adham404/Open8-VGA/enclosure/out/img/front.png

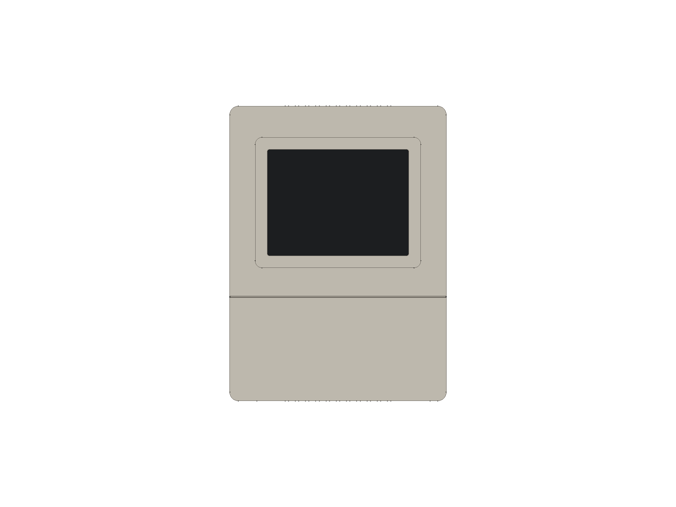
enclosure/out/img/front.png
