adham404/Open8-VGA/enclosure/out/img/rear_right.png

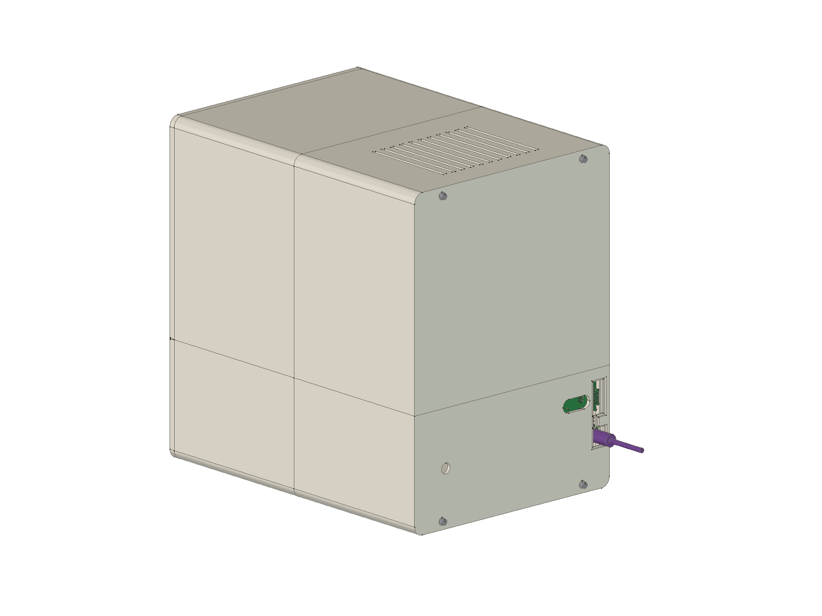
enclosure/out/img/rear_right.png
