adham404/Open8-VGA/hardware/fab/rev-a/open8-vga-top-revA.png

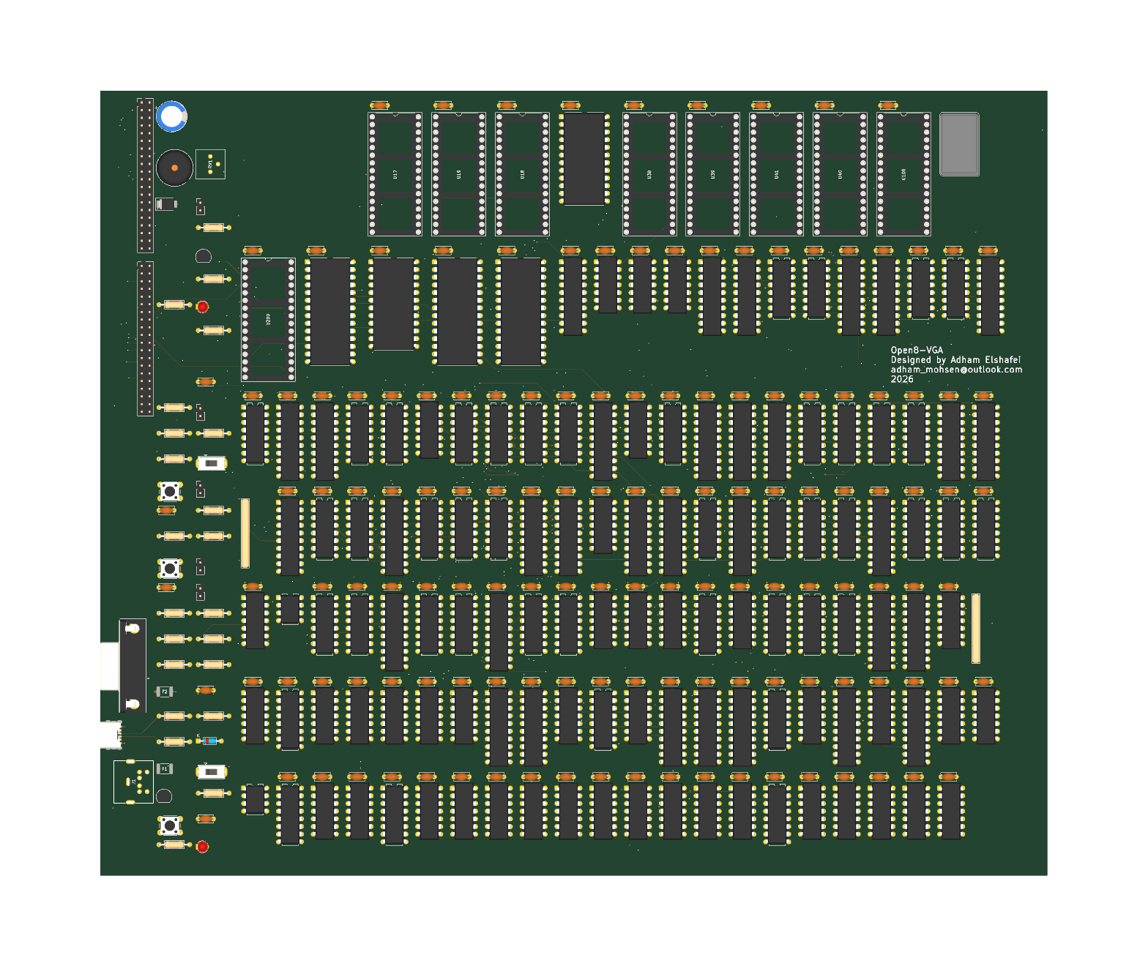
hardware/fab/rev-a/open8-vga-top-revA.png
