adham404/Open8-VGA/enclosure/out/shell_lower_rear.stl

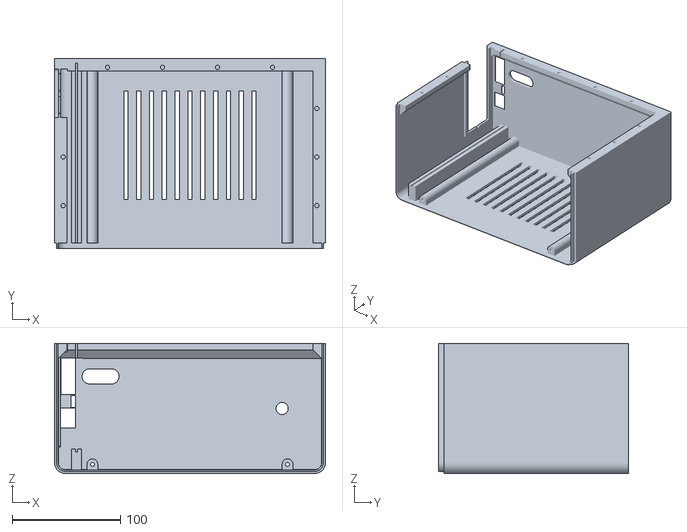
[picture p19: CAD file, 2026-10-21]
enclosure/out/shell_lower_rear.stl
250.0 x 175.0 x 120.0
