adham404/Open8-VGA/enclosure/out/shell_lower_front.stl

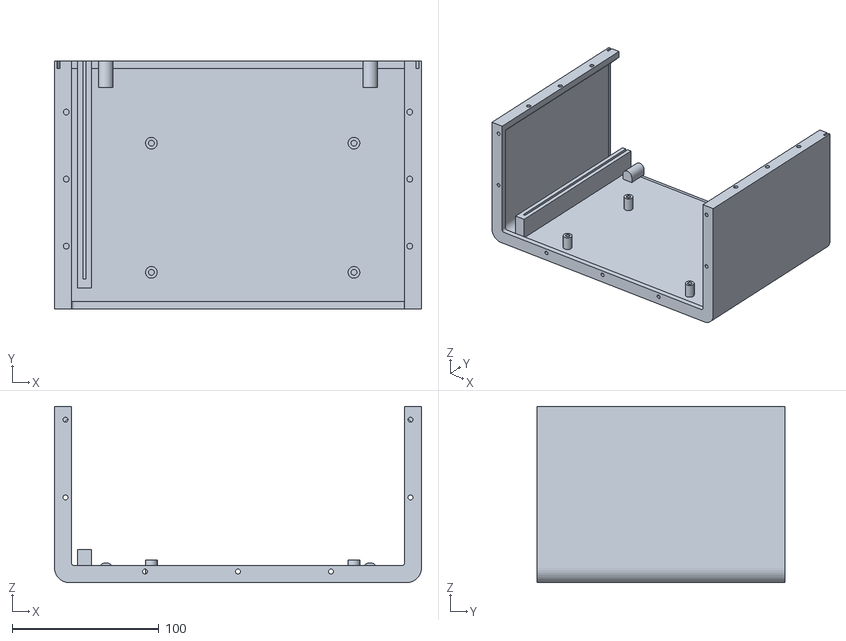
[picture p20: CAD file, 2026-10-21]
enclosure/out/shell_lower_front.stl
250.0 x 169.0 x 120.0
