adham404/Open8-VGA/enclosure/out/open8-vga-enclosure.step

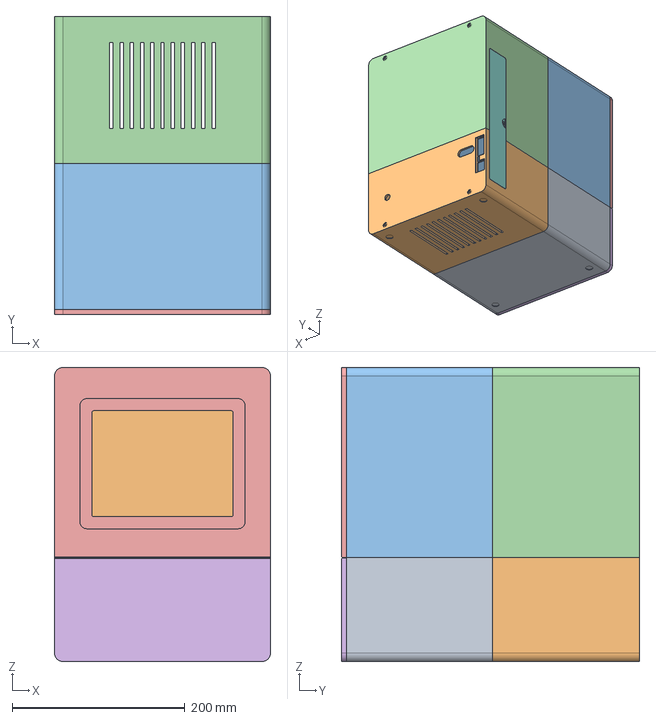
[picture p21: CAD file, 2026-10-21]
enclosure/out/open8-vga-enclosure.step
250.0 x 345.0 x 340.0 mm
