adham404/Open8-VGA/enclosure/out/shell_upper_rear.stl

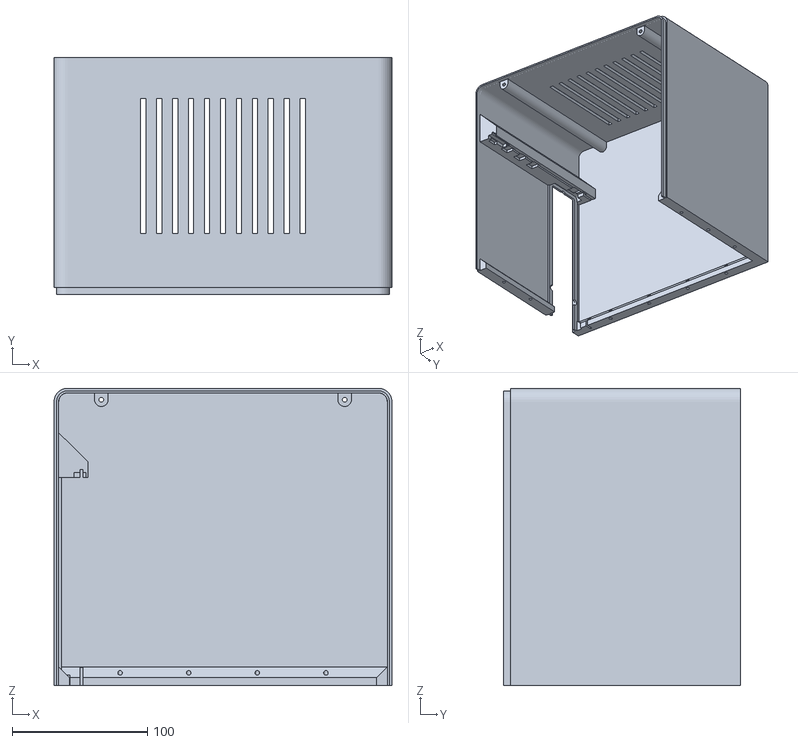
[picture p22: CAD file, 2026-10-21]
enclosure/out/shell_upper_rear.stl
250.0 x 175.0 x 220.0
