adham404/Open8-VGA/enclosure/out/bezel_upper.stl

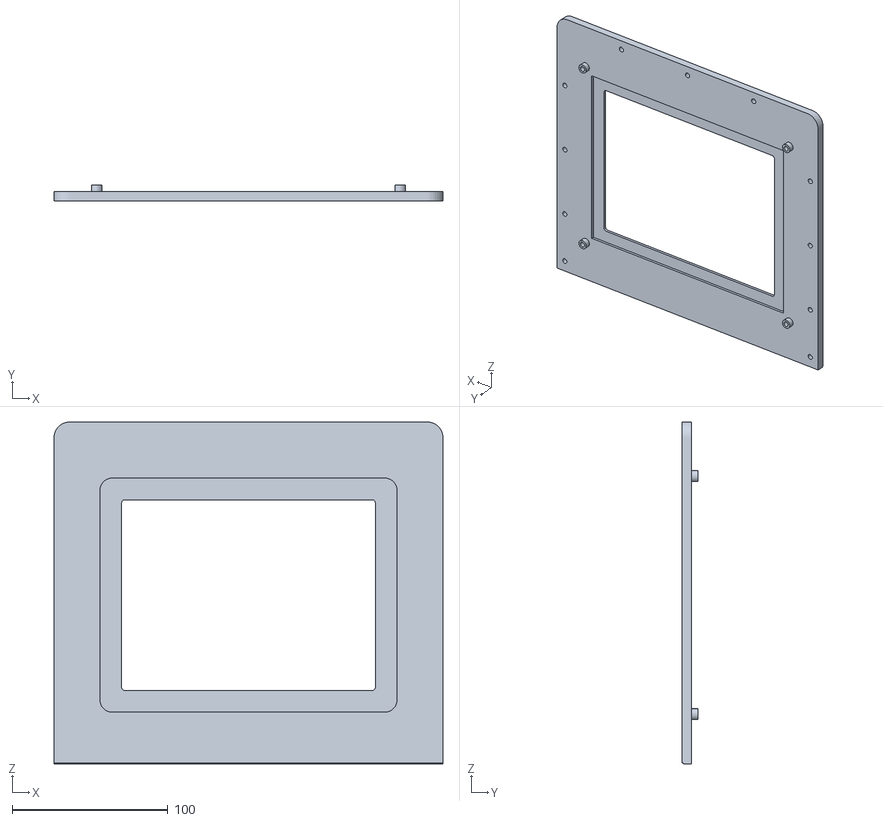
[picture p24: CAD file, 2026-10-20]
enclosure/out/bezel_upper.stl
250.0 x 10.0 x 219.8
