adham404/Open8-VGA/enclosure/out/controls_door.stl

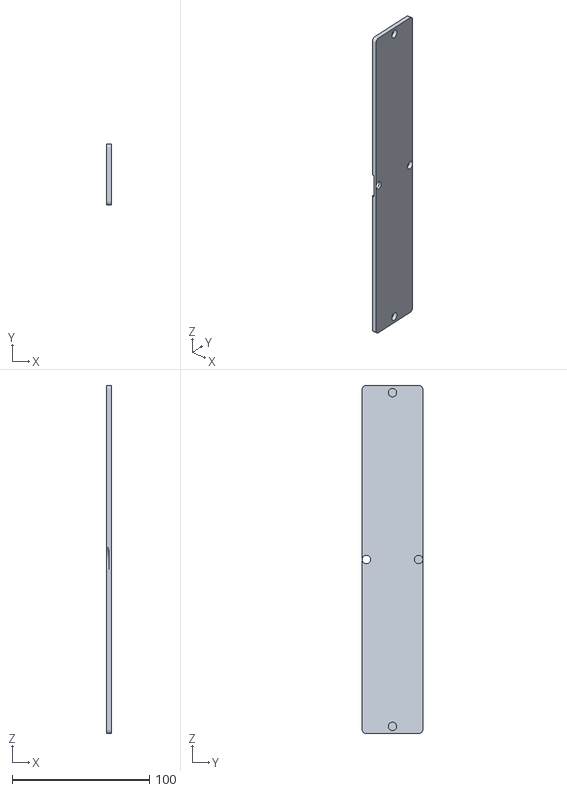
[picture p25: CAD file, 2026-10-20]
enclosure/out/controls_door.stl
3.50 x 44.4 x 253.5
