adham404/Open8-VGA/enclosure/out/driver_tray.stl

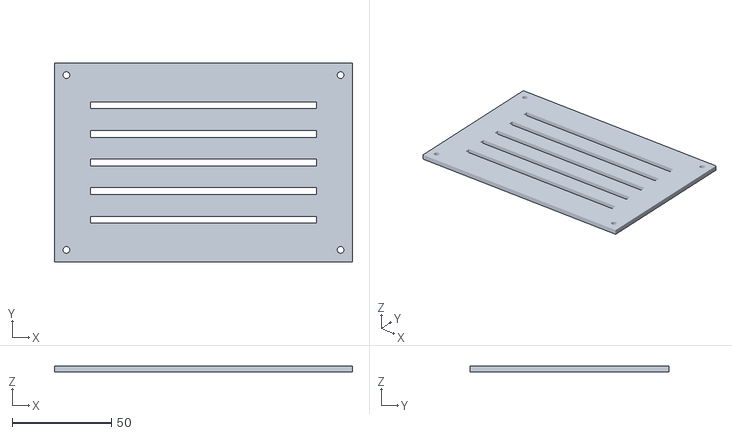
[picture p26: CAD file, 2026-10-20]
enclosure/out/driver_tray.stl
150.0 x 100.0 x 3.00
