adham404/Open8-VGA/enclosure/out/panel_clamp.stl

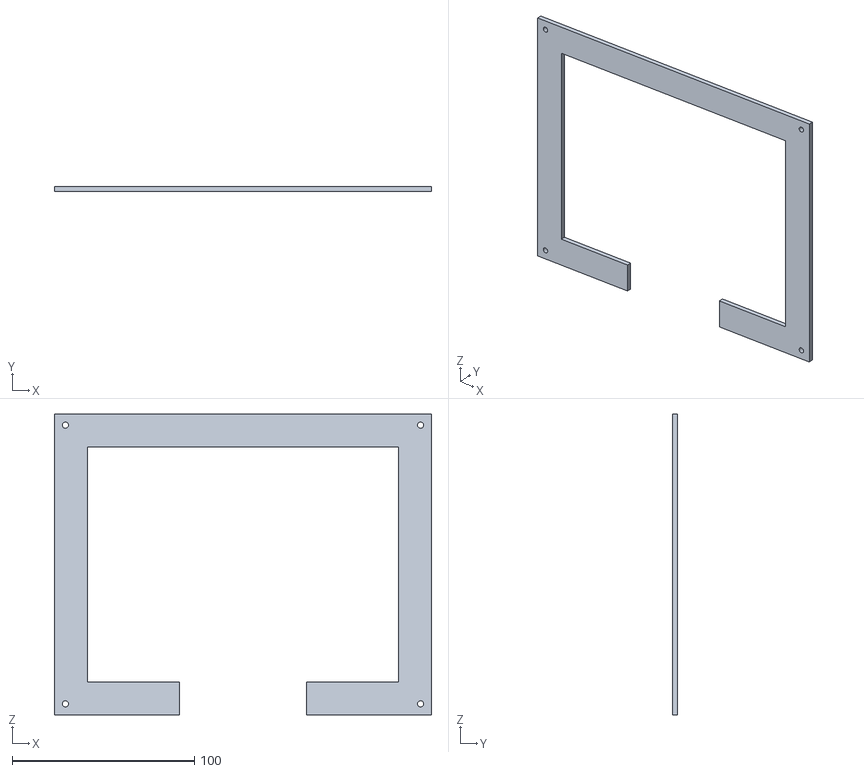
[picture p27: CAD file, 2026-10-20]
enclosure/out/panel_clamp.stl
207.0 x 3.00 x 165.0
