adham404/Open8-VGA/enclosure/out/bezel_chin.stl

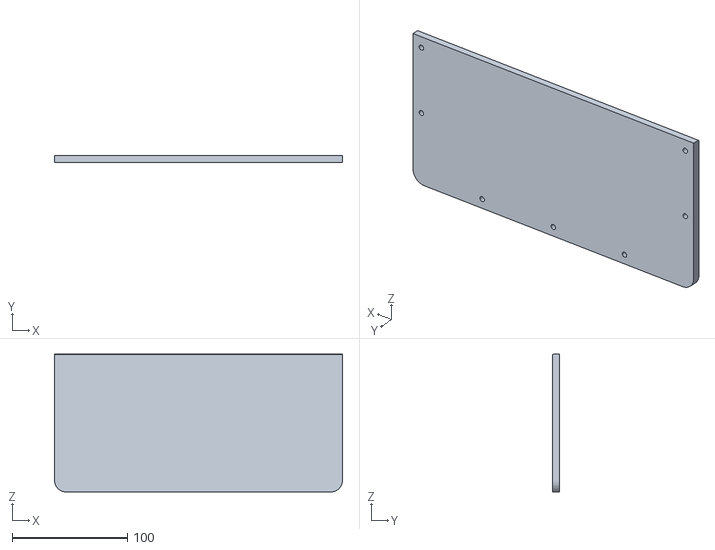
[picture p28: CAD file, 2026-10-20]
enclosure/out/bezel_chin.stl
250.0 x 6.00 x 119.8
