adham404/Open8-VGA/(list of files, cad)

Other CAD files:
enclosure/out/open8-vga-enclosure.FCStd
