adham404/Open8-VGA/kicad/board/open8-vga-motherboard.kicad_pcb

## KiCad design kicad/board/open8-vga-motherboard.kicad_pcb (2026-10-20)

Schematic: open8-vga-motherboard.kicad_sch, Open8-VGA motherboard

Parts:
BZ1: piezo; Buzzer_12x9.5RM7.6
C1, C2, C7, C8, C9, C10, C11, C12, C13, C14, C15, C16, C17, C18, C19, C20, C21, C22, C23, C24, C25, C26, C27, C28, C29, C30, C31, C32, C33, C34, C35, C36, C37, C38, C39, C40, C41, C42, C43, C44, C45, C46, C47, C48, C49, C50, C51, C52, C53, C54, C55, C56, C57, C58, C59, C60, C61, C62, C63, C64, C65, C66, C67, C68, C69, C70, C71, C72, C73, C74, C75, C76, C77, C78, C79, C80, C81, C82, C83, C84, C85, C86, C87, C88, C89, C90, C91, C92, C93, C94, C95, C96, C97, C98, C99, C100, C101, C102, C103, C104, C105, C106, C107, C108, C109, C110, C111, C112, C113, C114, C115, C116, C117, C118, C119, C120, C121, C122, C123, C124, C125, C126, C127, C128, C129, C130, C131, C132, C133, C134, C135, C136, C137, C138: 100n; C_Disc_D5.0mm_W2.5mm_P5.00mm
C3: 1u; C_Disc_D5.0mm_W2.5mm_P5.00mm
C4: 10n; C_Disc_D5.0mm_W2.5mm_P5.00mm
C5: 47n; C_Disc_D5.0mm_W2.5mm_P5.00mm
C6: 470u; CP_Radial_D10.0mm_P5.00mm
D1: 1N4148; D_DO-35_SOD27_P7.62mm_Horizontal; MPN 1N4148
D2: SMBJ5.0A; D_SMB; MPN SMBJ5.0A
D3: PWR; LED_D3.0mm
D4: HALT; LED_D3.0mm
F1: 200mA; Fuse_1812_4532Metric; MPN MF-MSMF020-2
F2: 2A; Fuse_1812_4532Metric; MPN MF-MSMF200-2
J1: PS/2; DC-IN-TH_MD-60SM; MPN MD-60SM
J2: VGA; DSUB-15-HD_Socket_Horizontal_P2.29x1.90mm_EdgePinOffset3.03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
J3: USB-C power; USB_C_Receptacle_GCT_USB4125-xx-x_6P_TopMnt_Horizontal
J4: LOGIC; PinHeader_2x20_P2.54mm_Vertical
J5: EXPANSION; PinHeader_2x20_P2.54mm_Vertical
JP1: HALF; PinHeader_1x02_P2.54mm_Vertical
JP2: MCBANK; PinHeader_1x02_P2.54mm_Vertical
JP3: COL_R; PinHeader_1x02_P2.54mm_Vertical
JP4: COL_G; PinHeader_1x02_P2.54mm_Vertical
JP5: COL_B; PinHeader_1x02_P2.54mm_Vertical
Q1: 2N3904; TO-92_Inline; MPN 2N3904
R1, R5, R6, R11, R13, R15: 10k; R_Axial_DIN0207_L6.3mm_D2.5mm_P10.16mm_Horizontal
R2, R3, R10: 47k; R_Axial_DIN0207_L6.3mm_D2.5mm_P10.16mm_Horizontal
R4, R7, R21, R22: 1k; R_Axial_DIN0207_L6.3mm_D2.5mm_P10.16mm_Horizontal
R8, R9: 4.7k; R_Axial_DIN0207_L6.3mm_D2.5mm_P10.16mm_Horizontal
R12, R14, R16: 470; R_Axial_DIN0207_L6.3mm_D2.5mm_P10.16mm_Horizontal
R17, R18: 100; R_Axial_DIN0207_L6.3mm_D2.5mm_P10.16mm_Horizontal
R19, R20: 5.1k; R_Axial_DIN0207_L6.3mm_D2.5mm_P10.16mm_Horizontal
RN1, RN2: 10k; R_Array_SIP9
RV1: 1M; Potentiometer_Bourns_3386P_Vertical
SW1: RESET; SW_PUSH_6mm
SW2: RUN/STEP; SW_Slide_SPDT_Straight_CK_OS102011MS2Q
SW3: STEP/SLOW; SW_Slide_SPDT_Straight_CK_OS102011MS2Q
SW4: STEP; SW_PUSH_6mm
SW5: CONTINUE; SW_PUSH_6mm
U1: 74AC161; DIP-16_W7.62mm; MPN CD74AC161E
U2, U130: 74AC04; DIP-14_W7.62mm; MPN CD74AC04E
U3, U113: 74HC86; DIP-14_W7.62mm; MPN CD74HC86E
U4, U14, U68, U72, U83, U98: 74HC08; DIP-14_W7.62mm; MPN CD74HC08E
U5, U109, U127, U129: 74AC574; DIP-20_W7.62mm; MPN CD74AC574E
U6, U48, U82, U96, U124: 74HC04; DIP-14_W7.62mm; MPN CD74HC04E
U7: MCP130-450; TO-92_Inline; MPN MCP130-450DI/TO
U8, U12, U15, U84, U85, U87: 74HC74; DIP-14_W7.62mm; MPN CD74HC74E
U9, U91: 74HC14; DIP-14_W7.62mm; MPN CD74HC14E
U10: NE555; DIP-8_W7.62mm; MPN NE555P
U11, U70, U71, U74: 74HC157; DIP-16_W7.62mm; MPN CD74HC157E
U13, U25, U26, U27, U69, U86, U99: 74HC32; DIP-14_W7.62mm; MPN CD74HC32E
U16, U131: 74AC08; DIP-14_W7.62mm; MPN CD74AC08E
U17, U18, U19, U108, U200: SST39SF010A; DIP-32_W15.24mm_Socket; MPN SST39SF010A-70-4C-PHE
U20, U100: 74HC02; DIP-14_W7.62mm; MPN CD74HC02E
U21, U49, U50, U51, U52, U103, U104, U105, U106, U107: 74HC163; DIP-16_W7.62mm; MPN CD74HC163E
U22, U30, U32, U34, U36, U37, U55, U56, U57, U78, U79, U80, U81: 74HC377; DIP-20_W7.62mm; MPN CD74HC377E
U23, U24: 74HC154; DIP-24_W15.24mm; MPN CD74HC154E
U28, U29, U59, U60, U61, U62, U63, U64, U65, U66: 74HC153; DIP-16_W7.62mm; MPN CD74HC153E
U31, U33, U35, U46, U47, U53, U54, U58, U88, U89, U101, U102: 74HC541; DIP-20_W7.62mm; MPN CD74HC541E
U38, U39, U40, U41: SST39SF040; DIP-32_W15.24mm_Socket; MPN SST39SF040-70-4C-PHE
U42, U43, U44, U45, U94: 74HC161; DIP-16_W7.62mm; MPN CD74HC161E
U67: 74AC138; DIP-16_W7.62mm; MPN CD74AC138E
U73, U117: 74HC00; DIP-14_W7.62mm; MPN CD74HC00E
U75, U76, U77: 74HC138; DIP-16_W7.62mm; MPN CD74HC138E
U90: 25LC512; DIP-8_W7.62mm; MPN 25LC512-I/P
U92, U93: 74HC164; DIP-14_W7.62mm; MPN CD74HC164E
U95, U123: 74HC11; DIP-14_W7.62mm; MPN CD74HC11E
U97: 74HC05; DIP-14_W7.62mm; MPN SN74HC05N
U110, U111, U112: 74HC283; DIP-16_W7.62mm; MPN CD74HC283E
U114, U115, U116, U120, U121, U122: 74AC157; DIP-16_W7.62mm; MPN CD74AC157E
U118, U125: 74AC245; DIP-20_W7.62mm; MPN CD74AC245E
U119, U126: 74HC574; DIP-20_W7.62mm; MPN CD74HC574E
U128: 74AC151; DIP-16_W7.62mm; MPN CD74AC151E
U201: AS6C62256; DIP-28_W15.24mm; MPN AS6C62256-55PCN
U202, U203: AS6C6264; DIP-28_W15.24mm; MPN AS6C6264-55PCN
X1: 25.175MHz; Oscillator_DIP-14; MPN ECS-100A-251.7

Connections:
A0: J4.1, J5.9, U49.3 (D0), U59.7 (Za), U75.1 (A0), U76.1 (A0), U77.1 (A0), U114.3 (I1a), U120.3 (I1a), U200.12 (A0), U201.10 (A0)
A1: J4.2, J5.10, U49.4 (D1), U59.9 (Zb), U75.2 (A1), U76.2 (A1), U77.2 (A1), U114.6 (I1b), U120.6 (I1b), U200.11 (A1), U201.9 (A1)
A2: J4.3, J5.11, U49.5 (D2), U60.7 (Za), U75.3 (A2), U76.3 (A2), U77.3 (A2), U114.10 (I1c), U120.10 (I1c), U200.10 (A2), U201.8 (A2)
A3: J4.4, J5.12, U49.6 (D3), U60.9 (Zb), U114.13 (I1d), U120.13 (I1d), U200.9 (A3), U201.7 (A3)
A4: J4.5, J5.13, U50.3 (D0), U61.7 (Za), U115.3 (I1a), U121.3 (I1a), U200.8 (A4), U201.6 (A4)
A5: J4.6, J5.14, U50.4 (D1), U61.9 (Zb), U115.6 (I1b), U121.6 (I1b), U200.7 (A5), U201.5 (A5)
A6: J4.7, J5.15, U50.5 (D2), U62.7 (Za), U115.10 (I1c), U121.10 (I1c), U200.6 (A6), U201.4 (A6)
A7: J4.8, J5.16, U50.6 (D3), U62.9 (Zb), U115.13 (I1d), U121.13 (I1d), U200.5 (A7), U201.3 (A7)
A8: J4.9, U51.3 (D0), U63.7 (Za), U116.3 (I1a), U122.3 (I1a), U200.27 (A8), U201.25 (A8)
A9: J4.10, U51.4 (D1), U63.9 (Zb), U116.6 (I1b), U122.6 (I1b), U200.26 (A9), U201.24 (A9)
A10: J4.11, U51.5 (D2), U64.7 (Za), U116.10 (I1c), U122.10 (I1c), U200.23 (A10), U201.21 (A10)
A11: J4.12, U51.6 (D3), U64.9 (Zb), U116.13 (I1d), U122.13 (I1d), U200.25 (A11), U201.23 (A11)
A12: J4.13, U52.3 (D0), U65.7 (Za), U67.1 (A0), U68.13, U70.2 (I0a), U201.2 (A12)
A13: J4.14, U52.4 (D1), U65.9 (Zb), U67.2 (A1), U68.12, U70.5 (I0b), U201.26 (A13)
A14: J4.15, U52.5 (D2), U66.7 (Za), U67.3 (A2), U69.4, U70.1 (S), U71.1 (S), U201.1 (A14)
A14OR: U69.6, U72.2
A15: J4.16, U48.3, U52.6 (D3), U66.9 (Zb), U67.4 (~E0), U72.1, U74.3 (I1a)
A15_N: U48.4, U201.20 (~CS)
A1312: U68.11, U69.5
AF0_0: U28.6 (I0a), U40.13 (D0)
AF0_1: U28.10 (I0b), U40.14 (D1)
AF0_2: U29.6 (I0a), U40.15 (D2)
AF0_3: U29.10 (I0b), U40.17 (D3)
AF1_0: U28.5 (I1a), U41.13 (D0)
AF1_1: U28.11 (I1b), U41.14 (D1)
AF1_2: U29.5 (I1a), U41.15 (D2)
AF1_3: U29.11 (I1b), U41.17 (D3)
ALUOP3_N: U6.12, U27.13
AQ0: U32.2 (Q0), U33.2 (A0)
AQ1: U32.5 (Q1), U33.3 (A1)
AQ2: U32.6 (Q2), U33.4 (A2)
AQ3: U32.9 (Q3), U33.5 (A3)
AQ4: U32.12 (Q4), U33.6 (A4)
AQ5: U32.15 (Q5), U33.7 (A5)
AQ6: U32.16 (Q6), U33.8 (A6)
AQ7: U32.19 (Q7), U33.9 (A7)
BANKW_N: U77.12 (~Y3), U78.1 (~E)
BK0: U70.3 (I1a), U78.2 (Q0)
BK1: U70.6 (I1b), U78.5 (Q1)
BK2: U70.10 (I1c), U78.6 (Q2)
BK3: U70.13 (I1d), U78.9 (Q3)
BK4: U71.3 (I1a), U78.12 (Q4)
BLANK: U109.17 (Q2), U129.3 (D1)
BLANKQ: U129.18 (Q1), U130.1
BLOCK: U48.9, U72.6, U83.2
BLOCK_N: U48.8, U72.10
BQ0: U34.2 (Q0), U35.2 (A0)
BQ1: U34.5 (Q1), U35.3 (A1)
BQ2: U34.6 (Q2), U35.4 (A2)
BQ3: U34.9 (Q3), U35.5 (A3)
BQ4: U34.12 (Q4), U35.6 (A4)
BQ5: U34.15 (Q5), U35.7 (A5)
BQ6: U34.16 (Q6), U35.8 (A6)
BQ7: U34.19 (Q7), U35.9 (A7)
CC1: U110.9 (C4), U111.7 (C0)
CE_ANY: U13.6, U13.9
CE_L: U15.5 (Q), U16.2
CE_RAW: U13.8, U15.2 (D)
CE_RUN: U4.11, U13.4
CE_STEP: U13.5, U14.3
CH0: U119.19 (Q0), U121.2 (I0a)
CH1: U119.18 (Q1), U121.5 (I0b)
CH2: U119.17 (Q2), U121.11 (I0c)
CH3: U119.16 (Q3), U121.14 (I0d)
CH4: U119.15 (Q4), U122.2 (I0a)
CH5: U119.14 (Q5), U122.5 (I0b)
CH6: U119.13 (Q6), U122.11 (I0c)
CH7: U119.12 (Q7), U122.14 (I0d)
CHARCLK: J4.38, U2.2, U8.3 (C), U8.11 (C), U12.3 (C), U12.11 (C), U16.1, U87.3 (C), U103.2 (CP), U104.2 (CP), U105.2 (CP), U106.2 (CP), U107.2 (CP), U109.11 (Cp), U127.11 (Cp)
COL0: U110.4 (S1), U114.2 (I0a)
COL1: U110.1 (S2), U114.5 (I0b)
COL2: U110.13 (S3), U114.11 (I0c)
COL3: U110.10 (S4), U114.14 (I0d)
COL4: U111.4 (S1), U115.2 (I0a)
COL5: U111.1 (S2), U115.5 (I0b)
COL6: U111.13 (S3), U115.11 (I0c)
COLEN_B: JP5.1, R15.1, U131.13
COLEN_G: JP4.1, R13.1, U131.10
COLEN_R: JP3.1, R11.1, U131.5
CONT: U9.4, U9.5
CONTBTN_RC: C2.1, R3.1, SW5.1, U9.3
CONT_N: U9.6, U14.4
CPUCLK: J4.25, J5.20, U15.11 (C), U16.3, U21.2 (CP), U22.11 (CP), U30.11 (CP), U32.11 (CP), U34.11 (CP), U36.11 (CP), U37.11 (CP), U42.2 (CP), U43.2 (CP), U44.2 (CP), U45.2 (CP), U49.2 (CP), U50.2 (CP), U51.2 (CP), U52.2 (CP), U55.11 (CP), U56.11 (CP), U57.11 (CP), U78.11 (CP), U79.11 (CP), U80.11 (CP), U81.11 (CP), U84.3 (C), U84.11 (C), U85.3 (C), U85.11 (C), U87.11 (C)
CTRL555: C4.1, U10.5 (CONT)
D0: J4.17, J5.1, RN1.2 (R1), U22.3 (D0), U28.3 (I3a), U28.4 (I2a), U31.18 (Y0), U32.3 (D0), U33.18 (Y0), U34.3 (D0), U35.18 (Y0), U36.3 (D0), U37.3 (D0), U38.13 (D0), U39.13 (D0), U42.3 (D0), U44.3 (D0), U46.18 (Y0), U47.18 (Y0), U53.18 (Y0), U54.18 (Y0), U55.3 (D0), U56.3 (D0), U57.3 (D0), U58.18 (Y0), U78.3 (D0), U79.3 (D0), U80.3 (D0), U81.3 (D0), U88.18 (Y0), U89.18 (Y0), U101.18 (Y0), U102.18 (Y0), U118.2 (A0), U125.2 (A0), U200.13 (D0), U201.11 (Q0)
D1: J4.18, J5.2, RN1.3 (R2), U22.4 (D1), U28.12 (I2b), U28.13 (I3b), U31.17 (Y1), U32.4 (D1), U33.17 (Y1), U34.4 (D1), U35.17 (Y1), U36.4 (D1), U37.4 (D1), U38.14 (D1), U39.14 (D1), U42.4 (D1), U44.4 (D1), U46.17 (Y1), U47.17 (Y1), U53.17 (Y1), U54.17 (Y1), U55.4 (D1), U56.4 (D1), U57.4 (D1), U58.17 (Y1), U78.4 (D1), U79.4 (D1), U80.4 (D1), U81.4 (D1), U88.17 (Y1), U89.17 (Y1), U101.17 (Y1), U102.17 (Y1), U118.3 (A1), U125.3 (A1), U200.14 (D1), U201.12 (Q1)
D2: J4.19, J5.3, RN1.4 (R3), U22.7 (D2), U29.3 (I3a), U29.4 (I2a), U31.16 (Y2), U32.7 (D2), U33.16 (Y2), U34.7 (D2), U35.16 (Y2), U36.7 (D2), U37.7 (D2), U38.15 (D2), U39.15 (D2), U42.5 (D2), U44.5 (D2), U46.16 (Y2), U47.16 (Y2), U53.16 (Y2), U54.16 (Y2), U55.7 (D2), U56.7 (D2), U57.7 (D2), U58.16 (Y2), U78.7 (D2), U79.7 (D2), U80.7 (D2), U81.7 (D2), U88.16 (Y2), U89.16 (Y2), U101.16 (Y2), U102.16 (Y2), U118.4 (A2), U125.4 (A2), U200.15 (D2), U201.13 (Q2)
D3: J4.20, J5.4, RN1.5 (R4), U22.8 (D3), U29.12 (I2b), U29.13 (I3b), U31.15 (Y3), U32.8 (D3), U33.15 (Y3), U34.8 (D3), U35.15 (Y3), U36.8 (D3), U37.8 (D3), U38.17 (D3), U39.17 (D3), U42.6 (D3), U44.6 (D3), U46.15 (Y3), U47.15 (Y3), U53.15 (Y3), U54.15 (Y3), U55.8 (D3), U56.8 (D3), U57.8 (D3), U58.15 (Y3), U78.8 (D3), U79.8 (D3), U80.8 (D3), U81.8 (D3), U88.15 (Y3), U89.15 (Y3), U101.15 (Y3), U102.15 (Y3), U118.5 (A3), U125.5 (A3), U200.17 (D3), U201.15 (Q3)
D4: J4.21, J5.5, RN1.6 (R5), U22.13 (D4), U31.14 (Y4), U32.13 (D4), U33.14 (Y4), U34.13 (D4), U35.14 (Y4), U36.13 (D4), U37.13 (D4), U38.18 (D4), U39.18 (D4), U43.3 (D0), U45.3 (D0), U46.14 (Y4), U47.14 (Y4), U53.14 (Y4), U54.14 (Y4), U55.13 (D4), U56.13 (D4), U57.13 (D4), U58.14 (Y4), U78.13 (D4), U79.13 (D4), U80.13 (D4), U81.13 (D4), U88.14 (Y4), U89.14 (Y4), U101.14 (Y4), U102.14 (Y4), U118.6 (A4), U125.6 (A4), U200.18 (D4), U201.16 (Q4)
D5: J4.22, J5.6, RN1.7 (R6), U22.14 (D5), U31.13 (Y5), U32.14 (D5), U33.13 (Y5), U34.14 (D5), U35.13 (Y5), U36.14 (D5), U37.14 (D5), U38.19 (D5), U39.19 (D5), U43.4 (D1), U45.4 (D1), U46.13 (Y5), U47.13 (Y5), U53.13 (Y5), U54.13 (Y5), U55.14 (D5), U56.14 (D5), U57.14 (D5), U58.13 (Y5), U78.14 (D5), U79.14 (D5), U80.14 (D5), U81.14 (D5), U88.13 (Y5), U89.13 (Y5), U101.13 (Y5), U102.13 (Y5), U118.7 (A5), U125.7 (A5), U200.19 (D5), U201.17 (Q5)
D6: J4.23, J5.7, RN1.8 (R7), U22.17 (D6), U31.12 (Y6), U32.17 (D6), U33.12 (Y6), U34.17 (D6), U35.12 (Y6), U36.17 (D6), U37.17 (D6), U38.20 (D6), U39.20 (D6), U43.5 (D2), U45.5 (D2), U46.12 (Y6), U47.12 (Y6), U53.12 (Y6), U54.12 (Y6), U55.17 (D6), U56.17 (D6), U57.17 (D6), U58.12 (Y6), U78.17 (D6), U79.17 (D6), U80.17 (D6), U81.17 (D6), U88.12 (Y6), U89.12 (Y6), U101.12 (Y6), U102.12 (Y6), U118.8 (A6), U125.8 (A6), U200.20 (D6), U201.18 (Q6)
D7: J4.24, J5.8, RN1.9 (R8), U22.18 (D7), U31.11 (Y7), U32.18 (D7), U33.11 (Y7), U34.18 (D7), U35.11 (Y7), U36.18 (D7), U37.18 (D7), U38.21 (D7), U39.21 (D7), U43.6 (D3), U45.6 (D3), U46.11 (Y7), U47.11 (Y7), U53.11 (Y7), U54.11 (Y7), U55.18 (D7), U56.18 (D7), U57.18 (D7), U58.11 (Y7), U78.18 (D7), U79.18 (D7), U80.18 (D7), U81.18 (D7), U88.11 (Y7), U89.11 (Y7), U101.11 (Y7), U102.11 (Y7), U118.9 (A7), U125.9 (A7), U200.21 (D7), U201.19 (Q7)
D555: R4.2, RV1.1, U10.7 (DISCH)
DOT0: U1.14 (Q0), U3.1, U128.11 (S0)
DOT1: U1.13 (Q1), U3.2, U128.10 (S1)
DOT2: U1.12 (Q2), U2.1, U4.1, U5.3 (D1), U15.3 (C), U119.11 (Cp), U126.11 (Cp), U128.9 (S2)
DOTCLK: U1.2 (CP), U2.3, U129.11 (Cp), X1.8 (OUT)
DOTCLK_N: U2.4, U5.11 (Cp)
DOTX: U3.3, U4.2
EE_CS_N: U86.6, U90.1 (~CS)
EE_MOSI: U81.5 (Q1), U90.5 (MOSI)
EE_SCK: U81.2 (Q0), U90.6 (SCK)
EXIN1: J5.26, RN2.3 (R2), U89.3 (A1)
EXIN2: J5.27, RN2.4 (R3), U89.4 (A2)
EXIN3: J5.28, RN2.5 (R4), U89.5 (A3)
EXIN4: J5.29, RN2.6 (R5), U89.6 (A4)
EXIN5: J5.30, RN2.7 (R6), U89.7 (A5)
EXIN6: J5.31, RN2.8 (R7), U89.8 (A6)
EXIN7: J5.32, RN2.9 (R8), U89.9 (A7)
FAD0: U120.4 (Za), U203.10 (A0)
FAD1: U120.7 (Zb), U203.9 (A1)
FAD2: U120.9 (Zc), U203.8 (A2)
FAD3: U120.12 (Zd), U203.7 (A3)
FAD4: U121.4 (Za), U203.6 (A4)
FAD5: U121.7 (Zb), U203.5 (A5)
FAD6: U121.9 (Zc), U203.4 (A6)
FAD7: U121.12 (Zd), U203.3 (A7)
FAD8: U122.4 (Za), U203.25 (A8)
FAD9: U122.7 (Zb), U203.24 (A9)
FAD10: U122.9 (Zc), U203.21 (A10)
FAD11: U122.12 (Zd), U203.23 (A11)
FBEN: U123.6, U124.1
FBOE_N: U124.2, U125.19 (CE)
FD0: U125.18 (B0), U126.2 (D0), U203.11 (I/O0)
FD1: U125.17 (B1), U126.3 (D1), U203.12 (I/O1)
FD2: U125.16 (B2), U126.4 (D2), U203.13 (I/O2)
FD3: U125.15 (B3), U126.5 (D3), U203.15 (I/O3)
FD4: U125.14 (B4), U126.6 (D4), U203.16 (I/O4)
FD5: U125.13 (B5), U126.7 (D5), U203.17 (I/O5)
FD6: U125.12 (B6), U126.8 (D6), U203.18 (I/O6)
FD7: U125.11 (B7), U126.9 (D7), U203.19 (I/O7)
FL0: U126.19 (Q0), U127.2 (D0)
FL1: U126.18 (Q1), U127.3 (D1)
FL2: U126.17 (Q2), U127.4 (D2)
FL3: U126.16 (Q3), U127.5 (D3)
FL4: U126.15 (Q4), U127.6 (D4)
FL5: U126.14 (Q5), U127.7 (D5)
FL6: U126.13 (Q6), U127.8 (D6)
FL7: U126.12 (Q7), U127.9 (D7)
FLAGLD_N: U20.4, U30.1 (~E)
FLAGSBUS: U6.10, U20.6, U28.2 (S1), U29.2 (S1)
FLAG_C: U17.12 (A0), U18.12 (A0), U19.12 (A0), U30.2 (Q0), U31.2 (A0)
FLAG_N: U17.10 (A2), U18.10 (A2), U19.10 (A2), U30.6 (Q2), U31.4 (A2)
FLAG_V: U17.9 (A3), U18.9 (A3), U19.9 (A3), U30.9 (Q3), U31.5 (A3)
FLAG_Z: U17.11 (A1), U18.11 (A1), U19.11 (A1), U30.5 (Q1), U31.3 (A1)
FN0: U28.7 (Za), U30.3 (D0)
FN1: U28.9 (Zb), U30.4 (D1)
FN2: U29.7 (Za), U30.7 (D2)
FN3: U29.9 (Zb), U30.8 (D3)
FNOE_N: U123.12, U203.22 (~OE)
FNSEL: U96.10, U117.10, U123.2, U123.4
FNSEL_N: U67.7 (~Y7), U96.11
FNWE_N: U117.8, U203.27 (~WE)
FROMRAM: U72.5, U74.2 (I0a), U87.9 (Q)
FR_D: U74.4 (Za), U87.12 (D)
GND: C1.2, C2.2, C3.2, C4.2, C5.2, C6.2, C7.2, C8.2, C9.2, C10.2, C11.2, C12.2, C13.2, C14.2, C15.2, C16.2, C17.2, C18.2, C19.2, C20.2, C21.2, C22.2, C23.2, C24.2, C25.2, C26.2, C27.2, C28.2, C29.2, C30.2, C31.2, C32.2, C33.2, C34.2, C35.2, C36.2, C37.2, C38.2, C39.2, C40.2, C41.2, C42.2, C43.2, C44.2, C45.2, C46.2, C47.2, C48.2, C49.2, C50.2, C51.2, C52.2, C53.2, C54.2, C55.2, C56.2, C57.2, C58.2, C59.2, C60.2, C61.2, C62.2, C63.2, C64.2, C65.2, C66.2, C67.2, C68.2, C69.2, C70.2, C71.2, C72.2, C73.2, C74.2, C75.2, C76.2, C77.2, C78.2, C79.2, C80.2, C81.2, C82.2, C83.2, C84.2, C85.2, C86.2, C87.2, C88.2, C89.2, C90.2, C91.2, C92.2, C93.2, C94.2, C95.2, C96.2, C97.2, C98.2, C99.2, C100.2, C101.2, C102.2, C103.2, C104.2, C105.2, C106.2, C107.2, C108.2, C109.2, C110.2, C111.2, C112.2, C113.2, C114.2, C115.2, C116.2, C117.2, C118.2, C119.2, C120.2, C121.2, C122.2, C123.2, C124.2, C125.2, C126.2, C127.2, C128.2, C129.2, C130.2, C131.2, C132.2, C133.2, C134.2, C135.2, C136.2, C137.2, C138.2, D2.2 (A2), D3.1 (K), D4.1 (K), J1.3, J1.7, J1.8, J1.9, J2.5, J2.6, J2.7, J2.8, J2.10, J2.SH, J3.A12 (GND), J3.B12 (GND), J3.SH (SHIELD), J4.40, J5.35, J5.36, J5.37, Q1.1 (E), R5.2, R6.2, R11.2, R13.2, R15.2, R19.2, R20.2, SW1.2, SW2.3 (C), SW3.3 (C), SW4.2, SW5.2, U1.3 (D0), U1.4 (D1), U1.5 (D2), U1.6 (D3), U1.8 (GND), U2.5, U2.7 (GND), U2.9, U2.11, U2.13, U3.4, U3.5, U3.7 (GND), U3.9, U3.10, U3.12, U3.13, U4.7 (GND), U5.1 (OE), U5.4 (D2), U5.5 (D3), U5.6 (D4), U5.7 (D5), U5.8 (D6), U5.9 (D7), U5.10 (GND), U6.7 (GND), U7.3 (VSS), U8.7 (GND), U9.7 (GND), U9.9, U9.11, U9.13, U10.1 (GND), U11.5 (I0b), U11.6 (I1b), U11.8 (GND), U11.10 (I1c), U11.11 (I0c), U11.13 (I1d), U11.14 (I0d), U11.15 (E), U12.7 (GND), U13.7 (GND), U14.7 (GND), U15.7 (GND), U16.4, U16.5, U16.7 (GND), U16.9, U16.10, U16.12, U16.13, U17.1 (A18), U17.16 (GND), U17.22 (CE), U17.24 (OE), U17.30 (A17), U18.1 (A18), U18.16 (GND), U18.22 (CE), U18.24 (OE), U18.30 (A17), U19.1 (A18), U19.16 (GND), U19.22 (CE), U19.24 (OE), U19.30 (A17), U20.7 (GND), U20.11, U20.12, U21.3 (D0), U21.4 (D1), U21.5 (D2), U21.6 (D3), U21.8 (GND), U22.10 (GND), U23.12 (GND), U23.18 (E0), U23.19 (E1), U24.12 (GND), U24.18 (E0), U24.19 (E1), U25.7 (GND), U26.7 (GND), U27.7 (GND), U28.1 (Ea), U28.8 (GND), U28.15 (Eb), U29.1 (Ea), U29.8 (GND), U29.15 (Eb), U30.10 (GND), U30.13 (D4), U30.14 (D5), U30.17 (D6), U30.18 (D7), U31.6 (A4), U31.7 (A5), U31.8 (A6), U31.9 (A7), U31.10 (GND), U31.19 (G2), U32.10 (GND), U33.10 (GND), U33.19 (G2), U34.10 (GND), U35.10 (GND), U35.19 (G2), U36.10 (GND), U37.10 (GND), U38.16 (GND), U38.22 (CE), U39.16 (GND), U39.22 (CE), U40.16 (GND), U40.22 (CE), U40.24 (OE), U41.16 (GND), U41.22 (CE), U41.24 (OE), U42.8 (GND), U43.8 (GND), U44.8 (GND), U45.8 (GND), U46.10 (GND), U46.19 (G2), U47.10 (GND), U47.19 (G2), U48.7 (GND), U49.8 (GND), U50.8 (GND), U51.8 (GND), U52.8 (GND), U53.10 (GND), U53.19 (G2), U54.10 (GND), U54.19 (G2), U55.10 (GND), U56.10 (GND), U57.10 (GND), U58.10 (GND), U58.19 (G2), U59.1 (Ea), U59.8 (GND), U59.15 (Eb), U60.1 (Ea), U60.8 (GND), U60.15 (Eb), U61.1 (Ea), U61.8 (GND), U61.15 (Eb), U62.1 (Ea), U62.8 (GND), U62.15 (Eb), U63.1 (Ea), U63.8 (GND), U63.15 (Eb), U64.1 (Ea), U64.8 (GND), U64.15 (Eb), U65.1 (Ea), U65.3 (I3a), U65.8 (GND), U65.15 (Eb), U66.1 (Ea), U66.3 (I3a), U66.8 (GND), U66.15 (Eb), U67.5 (~E1), U67.8 (GND), U68.7 (GND), U69.7 (GND), U70.8 (GND), U70.11 (I0c), U70.14 (I0d), U70.15 (E), U71.2 (I0a), U71.5 (I0b), U71.6 (I1b), U71.8 (GND), U71.10 (I1c), U71.11 (I0c), U71.13 (I1d), U71.14 (I0d), U71.15 (E), U72.7 (GND), U73.4, U73.5, U73.7 (GND), U73.9, U73.10, U73.12, U73.13, U74.5 (I0b), U74.6 (I1b), U74.8 (GND), U74.10 (I1c), U74.11 (I0c), U74.13 (I1d), U74.14 (I0d), U74.15 (E), U75.8 (GND), U76.8 (GND), U77.8 (GND), U78.10 (GND), U79.10 (GND), U80.10 (GND), U81.10 (GND), U82.3, U82.5, U82.7 (GND), U82.9, U82.11, U82.13, U83.7 (GND), U83.12, U83.13, U84.7 (GND), U85.7 (GND), U86.7 (GND), U86.9, U86.10, U86.12, U86.13, U87.7 (GND), U88.5 (A3), U88.6 (A4), U88.7 (A5), U88.8 (A6), U88.9 (A7), U88.10 (GND), U88.19 (G2), U89.10 (GND), U89.19 (G2), U90.4 (GND), U91.7 (GND), U91.13, U92.7 (GND), U93.7 (GND), U94.3 (D0), U94.4 (D1), U94.5 (D2), U94.6 (D3), U94.8 (GND), U95.7 (GND), U96.7 (GND), U97.3, U97.5, U97.7 (GND), U97.9, U97.11, U97.13, U98.4, U98.5, U98.7 (GND), U98.9, U98.10, U98.12, U98.13, U99.4, U99.5, U99.7 (GND), U99.9, U99.10, U99.12, U99.13, U100.5, U100.6, U100.7 (GND), U100.8, U100.9, U100.11, U100.12, U101.10 (GND), U101.19 (G2), U102.6 (A4), U102.7 (A5), U102.8 (A6), U102.9 (A7), U102.10 (GND), U102.19 (G2), U103.3 (D0), U103.4 (D1), U103.5 (D2), U103.6 (D3), U103.8 (GND), U104.3 (D0), U104.4 (D1), U104.5 (D2), U104.6 (D3), U104.8 (GND), U105.3 (D0), U105.4 (D1), U105.5 (D2), U105.6 (D3), U105.8 (GND), U106.3 (D0), U106.4 (D1), U106.5 (D2), U106.6 (D3), U106.8 (GND), U107.3 (D0), U107.4 (D1), U107.5 (D2), U107.6 (D3), U107.8 (GND), U108.1 (A18), U108.16 (GND), U108.22 (CE), U108.24 (OE), U108.30 (A17), U109.1 (OE), U109.8 (D6), U109.9 (D7), U109.10 (GND), U110.7 (C0), U110.8 (GND), U111.8 (GND), U111.11 (B4), U111.12 (A4), U112.7 (C0), U112.8 (GND), U113.7 (GND), U113.9, U113.10, U113.12, U113.13, U114.8 (GND), U114.15 (E), U115.8 (GND), U115.15 (E), U116.8 (GND), U116.15 (E), U117.7 (GND), U117.12, U117.13, U118.10 (GND), U119.1 (OE), U119.10 (GND), U120.8 (GND), U120.15 (E), U121.8 (GND), U121.15 (E), U122.8 (GND), U122.15 (E), U123.7 (GND), U123.9, U123.10, U123.11, U124.3, U124.5, U124.7 (GND), U124.9, U124.11, U124.13, U125.10 (GND), U126.1 (OE), U126.10 (GND), U127.1 (OE), U127.10 (GND), U128.7 (~E), U128.8 (GND), U129.1 (OE), U129.6 (D4), U129.7 (D5), U129.8 (D6), U129.9 (D7), U129.10 (GND), U130.3, U130.5, U130.7 (GND), U130.9, U130.11, U130.13, U131.7 (GND), U200.1 (A18), U200.16 (GND), U200.22 (CE), U200.30 (A17), U201.14 (GND), U202.2 (A12), U202.14 (GND), U202.20 (~CS1), U203.2 (A12), U203.14 (GND), U203.20 (~CS1), X1.7 (GND)
H0: U103.14 (Q0), U108.12 (A0), U110.5 (A1)
H1: U103.13 (Q1), U108.11 (A1), U110.3 (A2)
H2: U103.12 (Q2), U108.10 (A2), U110.14 (A3)
H3: U103.11 (Q3), U108.9 (A3), U110.12 (A4)
H4: U104.14 (Q0), U108.8 (A4), U111.5 (A1)
H5: U104.13 (Q1), U108.7 (A5), U111.3 (A2)
H6: U104.12 (Q2), U108.6 (A6), U111.14 (A3)
HALFOK: U4.13, U13.3
HALF_EN: JP1.1, R5.1, U6.9
HALF_N: U6.8, U13.2
HALTED: R22.1, U13.13, U15.9 (Q)
HALTED_N: U4.10, U15.8 (~Q)
HALT_D: U13.11, U15.12 (D)
HALT_LED: D4.2 (A), R22.2
HC0: U103.15 (TC), U104.10 (CET)
HCLR_N: U14.6, U15.13 (~R)
HRESET: U96.3, U105.7 (CEP), U105.10 (CET), U106.7 (CEP), U107.7 (CEP), U109.16 (Q3)
HRES_N: U96.4, U103.1 (~MR), U104.1 (~MR)
HSQ: J4.34, R17.1, U129.17 (Q2)
HSYNC_N: U109.19 (Q0), U129.4 (D2)
IN_RD_N: U75.7 (~Y7), U89.1 (G1)
IOSEL_N: J5.17, U67.10 (~Y5), U75.4 (~E0), U76.4 (~E0), U77.4 (~E0)
IR0: U17.27 (A8), U18.27 (A8), U19.27 (A8), U22.2 (Q0)
IR1: U17.26 (A9), U18.26 (A9), U19.26 (A9), U22.5 (Q1)
IR2: U17.23 (A10), U18.23 (A10), U19.23 (A10), U22.6 (Q2)
IR3: U17.25 (A11), U18.25 (A11), U19.25 (A11), U22.9 (Q3)
IR4: U17.4 (A12), U18.4 (A12), U19.4 (A12), U22.12 (Q4)
IR5: U17.28 (A13), U18.28 (A13), U19.28 (A13), U22.15 (Q5)
IR6: U17.29 (A14), U18.29 (A14), U19.29 (A14), U22.16 (Q6)
IR7: U17.3 (A15), U18.3 (A15), U19.3 (A15), U22.19 (Q7)
KBD_RAW: U48.12, U84.2 (D)
KBD_RAW_N: U48.13, U76.15 (~Y0)
KBD_RD_N: U75.15 (~Y0), U101.1 (G1)
KCLK: D1.1 (K), J1.5, J4.36, R8.1, U91.1, U97.2
KCLKI_N: U91.2, U92.8 (CP), U93.8 (CP), U94.2 (CP)
KCLR: U84.5 (Q), U99.1
KCLR_ANY: U99.3, U100.2
KCLR_N: U94.1 (~MR), U100.1
KDATA: J1.1, J4.37, R9.1, U91.3
KDATA_N: U91.4, U91.5
KDATI: U91.6, U92.1 (DSA)
KP0: U92.3 (Q0), U102.5 (A3)
KP1: U92.4 (Q1), U102.3 (A1)
KP2: U92.5 (Q2), U101.9 (A7)
KP3: U92.6 (Q3), U101.8 (A6)
KP4: U92.10 (Q4), U101.7 (A5)
KP5: U92.11 (Q5), U101.6 (A4)
KP6: U92.12 (Q6), U101.5 (A3)
KP7: U92.13 (Q7), U93.1 (DSA), U101.4 (A2)
KP8: U93.3 (Q0), U101.3 (A1)
KP9: U93.4 (Q1), U101.2 (A0)
KP10: U93.5 (Q2), U102.4 (A2)
KQ0: U94.14 (Q0), U95.1
KQ1: U94.13 (Q1), U95.2
KQ3: U94.11 (Q3), U95.13
KREADY: U95.12, U96.1, U97.1, U102.2 (A0)
KREADY_N: U94.7 (CEP), U94.10 (CET), U96.2, U98.2
KST_RD_N: U75.14 (~Y1), U102.1 (G1)
KTO: U91.10, U98.1
KTO_CLR: U98.3, U99.2
KTO_N: U91.8, U91.11
KTO_RC: C5.1, D1.2 (A), R10.2, U91.9
KVCC: F1.2, J1.4
LD_A_N: U24.2 (S1), U32.1 (~E)
LD_B_N: U24.3 (S2), U34.1 (~E)
LD_FLAGSBUS_N: U6.11, U24.14 (S12)
LD_IR: U48.10, U74.1 (S)
LD_IR_N: U22.1 (~E), U24.6 (S5), U48.11
LD_L_N: U24.5 (S4), U36.1 (~E)
LD_MARH_N: U24.8 (S7), U56.1 (~E)
LD_MARL_N: U24.7 (S6), U55.1 (~E)
LD_SP_N: U24.11 (S10), U57.1 (~E)
LD_T_N: U24.4 (S3), U37.1 (~E)
LD_XH_N: U24.10 (S9), U44.9 (~PE), U45.9 (~PE)
LD_XL_N: U24.9 (S8), U42.9 (~PE), U43.9 (~PE)
LQ0: U36.2 (Q0), U38.25 (A11), U39.25 (A11), U40.25 (A11), U41.25 (A11)
LQ1: U36.5 (Q1), U38.4 (A12), U39.4 (A12), U40.4 (A12), U41.4 (A12)
LQ2: U36.6 (Q2), U38.28 (A13), U39.28 (A13), U40.28 (A13), U41.28 (A13)
LQ3: U36.9 (Q3), U38.29 (A14), U39.29 (A14), U40.29 (A14), U41.29 (A14)
LQ4: U36.12 (Q4), U38.3 (A15), U39.3 (A15), U40.3 (A15), U41.3 (A15)
LQ5: U36.15 (Q5), U38.2 (A16), U39.2 (A16), U40.2 (A16), U41.2 (A16)
LQ6: U36.16 (Q6), U38.30 (A17), U39.30 (A17), U40.30 (A17), U41.30 (A17)
LQ7: U36.19 (Q7), U38.1 (A18), U39.1 (A18), U40.1 (A18), U41.1 (A18)
M0: U55.2 (Q0), U59.5 (I1a)
M1: U55.5 (Q1), U59.11 (I1b)
M2: U55.6 (Q2), U60.5 (I1a)
M3: U55.9 (Q3), U60.11 (I1b)
M4: U55.12 (Q4), U61.5 (I1a)
M5: U55.15 (Q5), U61.11 (I1b)
M6: U55.16 (Q6), U62.5 (I1a)
M7: U55.19 (Q7), U62.11 (I1b)
M8: U56.2 (Q0), U63.5 (I1a)
M9: U56.5 (Q1), U63.11 (I1b)
M10: U56.6 (Q2), U64.5 (I1a)
M11: U56.9 (Q3), U64.11 (I1b)
M12: U56.12 (Q4), U65.5 (I1a)
M13: U56.15 (Q5), U65.11 (I1b)
M14: U56.16 (Q6), U66.5 (I1a)
M15: U56.19 (Q7), U66.11 (I1b)
MC0: U17.13 (D0), U23.23 (A0)
MC1: U17.14 (D1), U23.22 (A1)
MC2: U17.15 (D2), U23.21 (A2)
MC3: U17.17 (D3), U23.20 (A3)
MC4: U17.18 (D4), U24.23 (A0)
MC5: U17.19 (D5), U24.22 (A1)
MC6: U17.20 (D6), U24.21 (A2)
MC7: U17.21 (D7), U24.20 (A3)
MC8: U18.13 (D0), U38.12 (A0), U39.12 (A0), U40.12 (A0), U41.12 (A0)
MC9: U18.14 (D1), U38.11 (A1), U39.11 (A1), U40.11 (A1), U41.11 (A1)
MC10: U18.15 (D2), U38.10 (A2), U39.10 (A2), U40.10 (A2), U41.10 (A2)
MC11: U6.13, U18.17 (D3), U27.10, U28.14 (S0), U29.14 (S0)
MC12: U18.18 (D4), U59.14 (S0), U60.14 (S0), U61.14 (S0), U62.14 (S0), U63.14 (S0), U64.14 (S0), U65.14 (S0), U66.14 (S0)
MC13: U18.19 (D5), U59.2 (S1), U60.2 (S1), U61.2 (S1), U62.2 (S1), U63.2 (S1), U64.2 (S1), U65.2 (S1), U66.2 (S1)
MC14: U18.20 (D6), U49.7 (CEP), U49.10 (CET), U50.7 (CEP), U51.7 (CEP), U52.7 (CEP)
MC15: U18.21 (D7), U48.1
MC16: U19.13 (D0), U42.7 (CEP), U42.10 (CET), U43.7 (CEP), U44.7 (CEP), U45.7 (CEP)
MC17: U19.14 (D1), U20.5
MC18: U19.15 (D2), U20.2
MC19: U13.12, U19.17 (D3)
MC20: U19.18 (D4), U20.8
MC21: U19.19 (D5), U69.9
MC22: U19.20 (D6)
MC23: U19.21 (D7)
MCBANK: JP2.1, R6.1, U17.2 (A16), U18.2 (A16), U19.2 (A16)
MEMOP: U95.11, U117.3, U123.5
MISO: RN2.2 (R1), U89.2 (A0), U90.2 (MISO)
OE_ALU_N: U25.8, U27.9, U27.12
OE_AR0_N: U27.8, U38.24 (OE)
OE_AR1_N: U27.11, U39.24 (OE)
OE_A_N: U25.3, U33.1 (G1)
OE_B_N: U25.6, U35.1 (G1)
OE_FLAGS_N: U27.3, U31.1 (G1)
OE_PCH_N: U26.11, U54.1 (G1)
OE_PCL_N: U26.8, U53.1 (G1)
OE_SP_N: U26.6, U58.1 (G1)
OE_XH_N: U26.3, U47.1 (G1)
OE_XL_N: U25.11, U46.1 (G1)
OUT2: U81.6 (Q2), U86.4
OUT3: R7.1, U81.9 (Q3)
OUT4: J5.22, U81.12 (Q4)
OUT5: J5.23, U81.15 (Q5)
OUT6: J5.24, U81.16 (Q6)
OUT7: J5.25, U81.19 (Q7)
OUTW_N: U77.9 (~Y6), U81.1 (~E)
P0: U49.14 (Q0), U53.2 (A0), U59.6 (I0a)
P1: U49.13 (Q1), U53.3 (A1), U59.10 (I0b)
P2: U49.12 (Q2), U53.4 (A2), U60.6 (I0a)
P3: U49.11 (Q3), U53.5 (A3), U60.10 (I0b)
P4: U50.14 (Q0), U53.6 (A4), U61.6 (I0a)
P5: U50.13 (Q1), U53.7 (A5), U61.10 (I0b)
P6: U50.12 (Q2), U53.8 (A6), U62.6 (I0a)
P7: U50.11 (Q3), U53.9 (A7), U62.10 (I0b)
P8: U51.14 (Q0), U54.2 (A0), U63.6 (I0a)
P9: U51.13 (Q1), U54.3 (A1), U63.10 (I0b)
P10: U51.12 (Q2), U54.4 (A2), U64.6 (I0a)
P11: U51.11 (Q3), U54.5 (A3), U64.10 (I0b)
P12: U52.14 (Q0), U54.6 (A4), U65.6 (I0a)
P13: U52.13 (Q1), U54.7 (A5), U65.10 (I0b)
P14: U52.12 (Q2), U54.8 (A6), U66.6 (I0a)
P15: U52.11 (Q3), U54.9 (A7), U66.10 (I0b)
PC0: U49.15 (TC), U50.10 (CET)
PC1: U50.15 (TC), U51.10 (CET)
PC2: U51.15 (TC), U52.10 (CET)
PCCLR_N: U20.10, U49.1 (~MR), U50.1 (~MR), U51.1 (~MR), U52.1 (~MR)
PCLOAD_N: U48.2, U49.9 (~PE), U50.9 (~PE), U51.9 (~PE), U52.9 (~PE)
PH2: U5.18 (Q1), U95.3, U114.1 (S), U115.1 (S), U116.1 (S), U120.1 (S), U121.1 (S), U122.1 (S), U123.1
PIXQ: U129.19 (Q0), U131.1
PIXR: U128.5 (Z), U129.2 (D0)
PROT: U72.3, U72.4
PULSE: U4.6, U14.2
PWR_LED: D3.2 (A), R21.2
PX0: U127.19 (Q0), U128.12 (I7)
PX1: U127.18 (Q1), U128.13 (I6)
PX2: U127.17 (Q2), U128.14 (I5)
PX3: U127.16 (Q3), U128.15 (I4)
PX4: U127.15 (Q4), U128.1 (I3)
PX5: U127.14 (Q5), U128.2 (I2)
PX6: U127.13 (Q6), U128.3 (I1)
PX7: U127.12 (Q7), U128.4 (I0)
RA12: U70.4 (Za), U200.4 (A12)
RA13: U70.7 (Zb), U200.28 (A13)
RA14: U70.9 (Zc), U200.29 (A14)
RA15: U70.12 (Zd), U200.3 (A15)
RA16: U71.4 (Za), U200.2 (A16)
RAMWE_N: U73.3, U201.27 (~WE)
RC1: U112.9 (C4), U113.5
RD_N: J4.32, J5.18, U27.6, U69.2, U75.5 (~E1), U201.22 (~OE)
RG0_N: U14.9, U67.15 (~Y0)
RG01_N: U14.8, U68.1
RG1_N: U14.10, U67.14 (~Y1)
RG2_N: U14.12, U67.13 (~Y2)
RG3_N: U14.13, U67.12 (~Y3)
RG03_N: U68.3, U68.4
RG4_N: U67.11 (~Y4), U68.5
RG23_N: U14.11, U68.2
ROMOE_N: U69.3, U200.24 (OE)
ROMSEL_N: J4.33, U68.6, U69.1
ROW0: U112.4 (S1), U115.14 (I0d)
ROW1: U112.1 (S2), U116.2 (I0a)
ROW2: U112.13 (S3), U116.5 (I0b)
ROW3: U112.10 (S4), U116.11 (I0c)
ROW4: U113.6, U116.14 (I0d)
ROWX: U113.3, U113.4
RST: U6.4, U13.10, U20.3, U20.9, U86.5, U100.3
RSTRAW_N: R1.1, SW1.1, U7.1 (~RST), U8.2 (D)
RST_N: J4.26, J5.21, U6.3, U8.5 (Q), U14.5, U84.1 (~R), U84.13 (~R), U85.1 (~R), U85.13 (~R)
RUN: U4.9, U6.6
RUNOK: U4.8, U4.12
S0: U57.2 (Q0), U58.2 (A0), U59.3 (I3a)
S1: U57.5 (Q1), U58.3 (A1), U59.13 (I3b)
S2: U57.6 (Q2), U58.4 (A2), U60.3 (I3a)
S3: U57.9 (Q3), U58.5 (A3), U60.13 (I3b)
S4: U57.12 (Q4), U58.6 (A4), U61.3 (I3a)
S5: U57.15 (Q5), U58.7 (A5), U61.13 (I3b)
S6: U57.16 (Q6), U58.8 (A6), U62.3 (I3a)
S7: U57.19 (Q7), U58.9 (A7), U62.13 (I3b)
SLOWCLK: U10.3 (OUT), U11.3 (I1a)
SLOW_SEL: SW3.2 (B), U11.1 (S)
SPK_B: Q1.2 (B), R7.2
SPK_C: BZ1.2 (-), Q1.3 (C)
SRC_ALU_N: U23.4 (S3), U25.9
SRC_A_N: U23.2 (S1), U25.1
SRC_B_N: U23.3 (S2), U25.4
SRC_FLAGS_N: U23.11 (S10), U27.1
SRC_MEM_N: U23.5 (S4), U27.4, U76.5 (~E1), U117.1
SRC_PCH_N: U23.10 (S9), U26.12
SRC_PCL_N: U23.9 (S8), U26.9
SRC_SP_N: U23.8 (S7), U26.4
SRC_XH_N: U23.7 (S6), U26.1
SRC_XL_N: U23.6 (S5), U25.12
STEP0: J4.27, U17.8 (A4), U18.8 (A4), U19.8 (A4), U21.14 (Q0)
STEP1: J4.28, U17.7 (A5), U18.7 (A5), U19.7 (A5), U21.13 (Q1)
STEP2: J4.29, U17.6 (A6), U18.6 (A6), U19.6 (A6), U21.12 (Q2)
STEP3: J4.30, U17.5 (A7), U18.5 (A7), U19.5 (A7), U21.11 (Q3)
STEPBTN: U9.2, U11.2 (I0a)
STEPBTN_RC: C1.1, R2.1, SW4.1, U9.1
STEPCLR_N: U20.1, U21.1 (~MR)
STEPSRC: U11.4 (Za), U12.2 (D)
STEPSYNC1: U4.4, U12.5 (Q), U12.12 (D)
STEPSYNC2_N: U4.5, U12.8 (~Q)
STEP_MODE: SW2.2 (B), U6.5, U14.1
SX0: U79.2 (Q0), U110.6 (B1)
SX1: U79.5 (Q1), U110.2 (B2)
SX2: U79.6 (Q2), U110.15 (B3)
SX3: U79.9 (Q3), U110.11 (B4)
SX4: U79.12 (Q4), U111.6 (B1)
SX5: U79.15 (Q5), U111.2 (B2)
SX6: U79.16 (Q6), U111.15 (B3)
SXW_N: U77.11 (~Y4), U79.1 (~E)
SY0: U80.2 (Q0), U112.6 (B1)
SY1: U80.5 (Q1), U112.2 (B2)
SY2: U80.6 (Q2), U112.15 (B3)
SY3: U80.9 (Q3), U112.11 (B4)
SY4: U80.12 (Q4), U113.2
SYSW_N: U72.13, U77.13 (~Y2), U83.5
SYS_RAW: U82.2, U84.12 (D)
SYS_RAW_N: U76.13 (~Y2), U82.1
SYS_RD_N: U75.13 (~Y2), U88.1 (G1)
SYW_N: U77.10 (~Y5), U80.1 (~E)
T555: C3.1, RV1.2, RV1.3, U10.2 (TRIG), U10.6 (THRES)
TOG: U8.9 (Q), U13.1
TOG_N: U8.8 (~Q), U8.12 (D)
TQ0: U37.2 (Q0), U38.9 (A3), U39.9 (A3), U40.9 (A3), U41.9 (A3)
TQ1: U37.5 (Q1), U38.8 (A4), U39.8 (A4), U40.8 (A4), U41.8 (A4)
TQ2: U37.6 (Q2), U38.7 (A5), U39.7 (A5), U40.7 (A5), U41.7 (A5)
TQ3: U37.9 (Q3), U38.6 (A6), U39.6 (A6), U40.6 (A6), U41.6 (A6)
TQ4: U37.12 (Q4), U38.5 (A7), U39.5 (A7), U40.5 (A7), U41.5 (A7)
TQ5: U37.15 (Q5), U38.27 (A8), U39.27 (A8), U40.27 (A8), U41.27 (A8)
TQ6: U37.16 (Q6), U38.26 (A9), U39.26 (A9), U40.26 (A9), U41.26 (A9)
TQ7: U37.19 (Q7), U38.23 (A10), U39.23 (A10), U40.23 (A10), U41.23 (A10)
TR0: U108.13 (D0), U109.2 (D0)
TR1: U108.14 (D1), U109.3 (D1)
TR2: U108.15 (D2), U109.4 (D2)
TR3: U108.17 (D3), U109.5 (D3)
TR4: U108.18 (D4), U109.6 (D4)
TR5: U108.19 (D5), U109.7 (D5)
TRAPF: U72.12, U85.5 (Q), U88.3 (A1)
TRAP_D: U69.8, U85.2 (D)
TRAP_K: U69.10, U72.11
UNBLANK: U130.2, U131.2
USB_CC1: J3.A5 (CC1), R19.1
USB_CC2: J3.B5 (CC2), R20.1
V0: U105.14 (Q0), U108.5 (A7), U120.2 (I0a)
V1: U105.13 (Q1), U108.27 (A8), U120.5 (I0b)
V2: U105.12 (Q2), U108.26 (A9), U120.11 (I0c)
V3: U105.11 (Q3), U108.23 (A10), U120.14 (I0d)
V4: U106.14 (Q0), U108.25 (A11), U112.5 (A1)
V5: U106.13 (Q1), U108.4 (A12), U112.3 (A2)
V6: U106.12 (Q2), U108.28 (A13), U112.14 (A3)
V7: U106.11 (Q3), U108.29 (A14), U112.12 (A4)
V8: U107.14 (Q0), U108.3 (A15), U113.1
V9: U107.13 (Q1), U108.2 (A16)
VAD0: U114.4 (Za), U202.10 (A0)
VAD1: U114.7 (Zb), U202.9 (A1)
VAD2: U114.9 (Zc), U202.8 (A2)
VAD3: U114.12 (Zd), U202.7 (A3)
VAD4: U115.4 (Za), U202.6 (A4)
VAD5: U115.7 (Zb), U202.5 (A5)
VAD6: U115.9 (Zc), U202.4 (A6)
VAD7: U115.12 (Zd), U202.3 (A7)
VAD8: U116.4 (Za), U202.25 (A8)
VAD9: U116.7 (Zb), U202.24 (A9)
VAD10: U116.9 (Zc), U202.21 (A10)
VAD11: U116.12 (Zd), U202.23 (A11)
VB: R16.1, U131.11
VBEN: U95.8, U96.13
VBL: U83.9, U87.5 (Q), U88.2 (A0)
VBLS: U86.1, U109.14 (Q5)
VBL_D: U86.3, U87.2 (D)
VBL_K: U83.8, U86.2
VBOE_N: U96.12, U118.19 (CE)
VBUS: F2.1, J3.A9 (VBUS), J3.B9 (VBUS)
VC0: U105.15 (TC), U106.10 (CET)
VC1: U106.15 (TC), U107.10 (CET)
VCC: BZ1.1 (+), C6.1, C7.1, C8.1, C9.1, C10.1, C11.1, C12.1, C13.1, C14.1, C15.1, C16.1, C17.1, C18.1, C19.1, C20.1, C21.1, C22.1, C23.1, C24.1, C25.1, C26.1, C27.1, C28.1, C29.1, C30.1, C31.1, C32.1, C33.1, C34.1, C35.1, C36.1, C37.1, C38.1, C39.1, C40.1, C41.1, C42.1, C43.1, C44.1, C45.1, C46.1, C47.1, C48.1, C49.1, C50.1, C51.1, C52.1, C53.1, C54.1, C55.1, C56.1, C57.1, C58.1, C59.1, C60.1, C61.1, C62.1, C63.1, C64.1, C65.1, C66.1, C67.1, C68.1, C69.1, C70.1, C71.1, C72.1, C73.1, C74.1, C75.1, C76.1, C77.1, C78.1, C79.1, C80.1, C81.1, C82.1, C83.1, C84.1, C85.1, C86.1, C87.1, C88.1, C89.1, C90.1, C91.1, C92.1, C93.1, C94.1, C95.1, C96.1, C97.1, C98.1, C99.1, C100.1, C101.1, C102.1, C103.1, C104.1, C105.1, C106.1, C107.1, C108.1, C109.1, C110.1, C111.1, C112.1, C113.1, C114.1, C115.1, C116.1, C117.1, C118.1, C119.1, C120.1, C121.1, C122.1, C123.1, C124.1, C125.1, C126.1, C127.1, C128.1, C129.1, C130.1, C131.1, C132.1, C133.1, C134.1, C135.1, C136.1, C137.1, C138.1, D2.1 (A1), F1.1, F2.2, J4.39, J5.33, J5.34, JP1.2, JP2.2, JP3.2, JP4.2, JP5.2, R1.2, R2.2, R3.2, R4.1, R8.2, R9.2, R10.1, R21.1, RN1.1 (common), RN2.1 (common), SW2.1 (A), SW3.1 (A), U1.1 (~MR), U1.7 (CEP), U1.9 (~PE), U1.10 (CET), U1.16 (VCC), U2.14 (VCC), U3.14 (VCC), U4.14 (VCC), U5.20 (VCC), U6.14 (VCC), U7.2 (VDD), U8.1 (~R), U8.4 (~S), U8.10 (~S), U8.13 (~R), U8.14 (VCC), U9.14 (VCC), U10.4 (~RST), U10.8 (VCC), U11.16 (VCC), U12.1 (~R), U12.4 (~S), U12.10 (~S), U12.13 (~R), U12.14 (VCC), U13.14 (VCC), U14.14 (VCC), U15.1 (~R), U15.4 (~S), U15.10 (~S), U15.14 (VCC), U16.14 (VCC), U17.31 (PGM), U17.32 (VCC), U18.31 (PGM), U18.32 (VCC), U19.31 (PGM), U19.32 (VCC), U20.14 (VCC), U21.7 (CEP), U21.9 (~PE), U21.10 (CET), U21.16 (VCC), U22.20 (VCC), U23.24 (VCC), U24.24 (VCC), U25.14 (VCC), U26.14 (VCC), U27.14 (VCC), U28.16 (VCC), U29.16 (VCC), U30.20 (VCC), U31.20 (VCC), U32.20 (VCC), U33.20 (VCC), U34.20 (VCC), U35.20 (VCC), U36.20 (VCC), U37.20 (VCC), U38.31 (PGM), U38.32 (VCC), U39.31 (PGM), U39.32 (VCC), U40.31 (PGM), U40.32 (VCC), U41.31 (PGM), U41.32 (VCC), U42.1 (~MR), U42.16 (VCC), U43.1 (~MR), U43.16 (VCC), U44.1 (~MR), U44.16 (VCC), U45.1 (~MR), U45.16 (VCC), U46.20 (VCC), U47.20 (VCC), U48.14 (VCC), U49.16 (VCC), U50.16 (VCC), U51.16 (VCC), U52.16 (VCC), U53.20 (VCC), U54.20 (VCC), U55.20 (VCC), U56.20 (VCC), U57.20 (VCC), U58.20 (VCC), U59.16 (VCC), U60.16 (VCC), U61.16 (VCC), U62.16 (VCC), U63.3 (I3a), U63.13 (I3b), U63.16 (VCC), U64.3 (I3a), U64.13 (I3b), U64.16 (VCC), U65.13 (I3b), U65.16 (VCC), U66.13 (I3b), U66.16 (VCC), U67.6 (E2), U67.16 (VCC), U68.14 (VCC), U69.14 (VCC), U70.16 (VCC), U71.16 (VCC), U72.14 (VCC), U73.14 (VCC), U74.16 (VCC), U75.6 (E2), U75.16 (VCC), U76.6 (E2), U76.16 (VCC), U77.6 (E2), U77.16 (VCC), U78.20 (VCC), U79.20 (VCC), U80.20 (VCC), U81.20 (VCC), U82.14 (VCC), U83.14 (VCC), U84.4 (~S), U84.10 (~S), U84.14 (VCC), U85.4 (~S), U85.10 (~S), U85.14 (VCC), U86.14 (VCC), U87.1 (~R), U87.4 (~S), U87.10 (~S), U87.13 (~R), U87.14 (VCC), U88.20 (VCC), U89.20 (VCC), U90.3 (~WP), U90.7 (~HOLD), U90.8 (VCC), U91.14 (VCC), U92.2 (DSB), U92.9 (~MR), U92.14 (VCC), U93.2 (DSB), U93.9 (~MR), U93.14 (VCC), U94.9 (~PE), U94.16 (VCC), U95.14 (VCC), U96.14 (VCC), U97.14 (VCC), U98.14 (VCC), U99.14 (VCC), U100.14 (VCC), U101.20 (VCC), U102.20 (VCC), U103.7 (CEP), U103.9 (~PE), U103.10 (CET), U103.16 (VCC), U104.7 (CEP), U104.9 (~PE), U104.16 (VCC), U105.9 (~PE), U105.16 (VCC), U106.9 (~PE), U106.16 (VCC), U107.9 (~PE), U107.16 (VCC), U108.31 (PGM), U108.32 (VCC), U109.20 (VCC), U110.16 (VCC), U111.16 (VCC), U112.16 (VCC), U113.14 (VCC), U114.16 (VCC), U115.16 (VCC), U116.16 (VCC), U117.14 (VCC), U118.20 (VCC), U119.20 (VCC), U120.16 (VCC), U121.16 (VCC), U122.16 (VCC), U123.14 (VCC), U124.14 (VCC), U125.20 (VCC), U126.20 (VCC), U127.20 (VCC), U128.16 (VCC), U129.20 (VCC), U130.14 (VCC), U131.14 (VCC), U200.31 (PGM), U200.32 (VCC), U201.28 (VCC), U202.26 (CS2), U202.28 (VCC), U203.26 (CS2), U203.28 (VCC), X1.1 (EN), X1.14 (Vcc)
VCLR_N: U83.10, U84.8 (~Q)
VD0: U118.18 (B0), U119.2 (D0), U202.11 (I/O0)
VD1: U118.17 (B1), U119.3 (D1), U202.12 (I/O1)
VD2: U118.16 (B2), U119.4 (D2), U202.13 (I/O2)
VD3: U118.15 (B3), U119.5 (D3), U202.15 (I/O3)
VD4: U118.14 (B4), U119.6 (D4), U202.16 (I/O4)
VD5: U118.13 (B5), U119.7 (D5), U202.17 (I/O5)
VD6: U118.12 (B6), U119.8 (D6), U202.18 (I/O6)
VD7: U118.11 (B7), U119.9 (D7), U202.19 (I/O7)
VG: R14.1, U131.8
VGA_B: J2.3, R16.2
VGA_G: J2.2, R14.2
VGA_HS: J2.13, R17.2
VGA_R: J2.1, R12.2
VGA_VS: J2.14, R18.2
VIDEO: U131.3, U131.4, U131.9, U131.12
VIOLEV: U69.12, U83.3
VIOLF: U83.4, U85.9 (Q), U88.4 (A2)
VIOL_D: U69.11, U85.12 (D)
VIOL_K: U69.13, U83.6
VR: R12.1, U131.6
VRESET: U96.5, U109.15 (Q4)
VRES_N: U96.6, U105.1 (~MR), U106.1 (~MR), U107.1 (~MR)
VROE_N: U95.6, U202.22 (~OE)
VRSEL: U95.4, U95.10, U96.8, U117.5
VRSEL_N: U67.9 (~Y6), U96.9
VRWE_N: U117.6, U202.27 (~WE)
VSQ: J4.35, R18.1, U129.16 (Q3)
VSYNC_N: U109.18 (Q1), U129.5 (D3)
WIN: U5.19 (Q0), U6.1, U68.10, U95.9, U123.3
WINRAW: U4.3, U5.2 (D0)
WIN_N: U6.2, U25.2, U25.5, U25.10, U25.13, U26.2, U26.5, U26.10, U26.13, U27.2, U27.5
WR: U48.6, U68.9, U83.1, U95.5, U118.1 (A->B), U123.13, U125.1 (A->B)
WRP: U68.8, U72.9, U117.4, U117.9
WRP_OK: U72.8, U73.1, U73.2
WR_N: J4.31, J5.19, U24.13 (S11), U48.5, U77.5 (~E1), U117.2
X0: U42.14 (Q0), U46.2 (A0), U59.4 (I2a)
X1: U42.13 (Q1), U46.3 (A1), U59.12 (I2b)
X2: U42.12 (Q2), U46.4 (A2), U60.4 (I2a)
X3: U42.11 (Q3), U46.5 (A3), U60.12 (I2b)
X4: U43.14 (Q0), U46.6 (A4), U61.4 (I2a)
X5: U43.13 (Q1), U46.7 (A5), U61.12 (I2b)
X6: U43.12 (Q2), U46.8 (A6), U62.4 (I2a)
X7: U43.11 (Q3), U46.9 (A7), U62.12 (I2b)
X8: U44.14 (Q0), U47.2 (A0), U63.4 (I2a)
X9: U44.13 (Q1), U47.3 (A1), U63.12 (I2b)
X10: U44.12 (Q2), U47.4 (A2), U64.4 (I2a)
X11: U44.11 (Q3), U47.5 (A3), U64.12 (I2b)
X12: U45.14 (Q0), U47.6 (A4), U65.4 (I2a)
X13: U45.13 (Q1), U47.7 (A5), U65.12 (I2b)
X14: U45.12 (Q2), U47.8 (A6), U66.4 (I2a)
X15: U45.11 (Q3), U47.9 (A7), U66.12 (I2b)
XC0: U42.15 (TC), U43.10 (CET)
XC1: U43.15 (TC), U44.10 (CET)
XC2: U44.15 (TC), U45.10 (CET)

Notes on the sheet:
U92 74HC164
U107 74HC163
U117 74HC00
U98 74HC08
Connector — J3 USB-C power
U96 74HC04
U21 74HC163
U62 74HC153
U121 74AC157
U89 74HC541
U61 74HC153
U23 74HC154
Memory — U19 SST39SF010A
U84 74HC74
Memory — U201 AS6C62256
U48 74HC04
Memory — U202 AS6C6264
U72 74HC08
Memory — U203 AS6C6264
J1 PS/2
U88 74HC541
U74 74HC157
U15 74HC74
U8 74HC74
U105 74HC163
U63 74HC153
Memory — U41 SST39SF040
U114 74AC157
U31 74HC541
U102 74HC541
U25 74HC32
U53 74HC541
U103 74HC163
U128 74AC151
U58 74HC541
U124 74HC04
Memory — U200 SST39SF010A
U59 74HC153
U56 74HC377
U73 74HC00
U60 74HC153
U115 74AC157
U129 74AC574
U16 74AC08
U101 74HC541
U97 74HC05
U14 74HC08
U82 74HC04
U95 74HC11
U22 74HC377
U32 74HC377
U46 74HC541
U54 74HC541
U30 74HC377
Switch — Q1 2N3904
U9 74HC14
U43 74HC161
U2 74AC04
U109 74AC574
U13 74HC32
U116 74AC157
U44 74HC161
Memory — U18 SST39SF010A
U81 74HC377
Memory — U38 SST39SF040
U49 74HC163
U47 74HC541
U66 74HC153
U37 74HC377
U94 74HC161
U51 74HC163
Memory — U40 SST39SF040
U42 74HC161
U11 74HC157
U34 74HC377
U27 74HC32
U69 74HC32
U91 74HC14
U78 74HC377
U36 74HC377
Memory — U17 SST39SF010A
U122 74AC157
U85 74HC74
U12 74HC74
U130 74AC04
Connectors
U1 74AC161
U93 74HC164
U20 74HC02
U24 74HC154
U100 74HC02
U65 74HC153
U29 74HC153
U70 74HC157
U125 74AC245
U50 74HC163
Memory — U90 25LC512
U71 74HC157
U106 74HC163
U127 74AC574
U4 74HC08
U120 74AC157
U64 74HC153
U113 74HC86
U68 74HC08
U118 74AC245
U87 74HC74
U6 74HC04
U52 74HC163
U5 74AC574
U131 74AC08
U83 74HC08
Memory — U39 SST39SF040
U55 74HC377
U7 MCP130-450
U45 74HC161
Memory — U108 SST39SF010A
Timer — U10 NE555
U28 74HC153
U99 74HC32
U26 74HC32
U104 74HC163
U57 74HC377
U86 74HC32

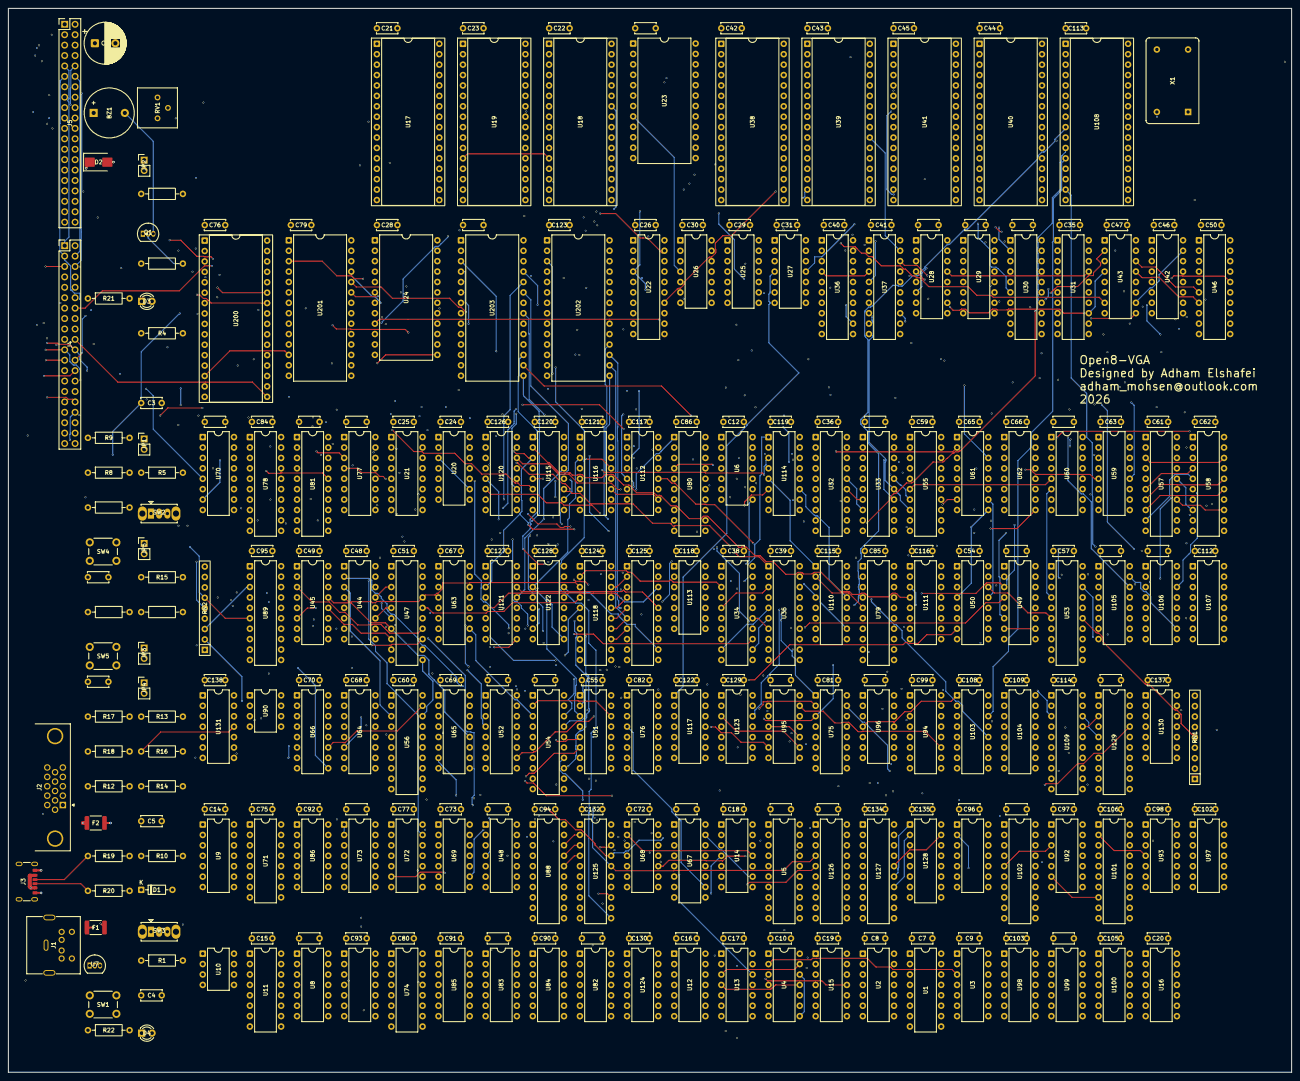
[picture p29: board open8-vga-motherboard.kicad_pcb from above]

Board: 6 copper layers, 313.0 x 259.5 mm, 322 parts (0 on the bottom side), 524 nets.
