adham404/Open8-VGA/(commit log)

2026-10-20 Open8-VGA: 8-bit computer from 74HC logic, first public release
    A microcoded 8-bit CPU with VGA text/tile video, a PS/2 keyboard and an
    EEPROM, built from 74HC/AC chips. It boots into an editor with an
    on-board assembler and runs games like Tetris and a platformer.
    - ISA, microcode, ROM ALU, assembler, simulators and boot firmware
    - Browser emulator (deployed to GitHub Pages by .github/workflows/pages.yml)
    - Board netlist as code with a gate-level simulator
    - Rev A PCB: 6-layer KiCad project, Gerbers, parts list, assembly and
    bring-up guides
    - 103 tests, run on every push by .github/workflows/tests.yml
    [open8-vga-bom-revA.csv, open8-vga-motherboard.kicad_pcb, open8-vga-motherboard.kicad_sch]
2026-10-20 Add a compact-Mac-style enclosure designed in FreeCAD
    A parametric FreeCAD script builds a 250 x 340 x 345 mm case for the
    Rev A board and an 8" 800x600 LCD (AT080TN52-class with a VGA driver
    board).
    - The board stands on the left wall in printed card-guide rails, with
    components facing out and the connector edge at the back.
    - A magnetic door in the left wall opens onto the control strip:
    buttons, slide switches, jumpers, LEDs and headers.
    - Four shell quarters plus bezel, chin, panel clamp, door and driver
    tray: every part fits a 256 mm bed and prints without supports.
    - The real board model from KiCad and the LCD are placed in the case;
    the build checks every pair for overlaps (a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
    [bezel_chin.stl, bezel_upper.stl, controls_door.stl, driver_tray.stl, open8-vga-enclosure.FCStd, open8-vga-enclosure.step, panel_clamp.stl, shell_lower_front.stl]
2026-10-20 Save the enclosure document with view state so it opens framed in FreeCAD
    A document saved by the command-line build has no view settings, so it
    opened with nothing in frame. render_views.py now saves it from the GUI
    with colours and a fitted isometric view.
    [open8-vga-enclosure.FCStd]
2026-10-21 Enclosure: join the front and rear halves with 4 rods from the back panel
    The mid-depth seam could only be bolted from inside, so the last seam closed
    was unreachable. The front and rear halves are now each assembled on their
    own (chin-line bolts reached through the open face), then joined by four M3
    rods from the back panel into inserts in front-half bosses, with a lap-joint
    tongue on the rear half aligning the walls. The fit check now covers the rods
    and the tongue in its rebate. Adds an exploded view and updates the README.
    [open8-vga-enclosure.FCStd, open8-vga-enclosure.step, shell_lower_front.stl, shell_lower_rear.stl, shell_upper_front.stl, shell_upper_rear.stl]
2026-10-21 Enclosure: open the back panel for the PS/2 keyboard plug
    J1's opening faces the board edge 4.2 mm in, so it was skipped by the
    back-panel cut-out filter and no plug could reach it; the right-wall
    extension socket could never connect either. Cut a PS/2 opening and recess
    in line with J1, drop the side socket and extension, and add a plug model to
    the fit check.
    [open8-vga-enclosure.FCStd, open8-vga-enclosure.step, shell_lower_front.stl, shell_lower_rear.stl]
2026-10-21 Enclosure: add a holder and back-panel window for the LCD menu keypad
    The display kit's menu keypad (brightness, VGA Auto adjust) had nowhere to
    go. Its board now slides down into two grooved posts on the inside of the
    back panel, buttons facing a window in the wall; size and button height are
    parameters. A keypad model joins the fit check.
    [open8-vga-enclosure.FCStd, open8-vga-enclosure.step, shell_lower_rear.stl]
2026-10-21 Enclosure: add a close-up render of the menu keypad holder to the README
    [open8-vga-enclosure.FCStd]
2026-10-21 Enclosure README: link the recommended LCD kit
2026-10-21 Enclosure README: explain where the menu keypad comes from, link a replacement
2026-10-21 Revert "Enclosure README: explain where the menu keypad comes from, link a replacement"
    This reverts commit 3325b8921e59af7d83023b9bc7aab6fa14c17526.
2026-10-21 Revert "Enclosure: add a close-up render of the menu keypad holder to the README"
    This reverts commit 44d3e47676ac1a6783868940030b8ae1ddc06299.
    [open8-vga-enclosure.FCStd]
2026-10-21 Revert "Enclosure: add a holder and back-panel window for the LCD menu keypad"
    This reverts commit 3ef8304ed89009912bc3b8caf84f3876dae9432e.
    [open8-vga-enclosure.FCStd, open8-vga-enclosure.step, shell_lower_rear.stl]
2026-10-21 Enclosure README: drop the keypad from the kit's shopping-list line
